foggyhlw/Motion-Sensor/README.md

# Motion-Sensor
## DIY人体存在传感器，使用LD2410雷达模块，辅助SR602热释电传感器避免误动，增加了BH1750光线传感器
## 视频教程：
### B站：https://www.bilibili.com/video/BV1Cs4y1Y7gm/
### 油管：https://www.youtube.com/watch?v=6fU20yu0re4&ab_channel=foggyhlw
