foggyhlw/Motion-Sensor/PCB打样相关文件/BOM清单.xlsx

No. | Quantity | Device | Designator | Footprint | 备注
1 | 3 | 1uf | C1,C6,C10 | C0805
2 | 2 | 100nF | C4,C5 | C0805
3 | 1 | 10uF | C9 | C0805
4 | 1 | FLASH | H1 | HDR-TH_4P-P2.54-V
5 | 1 | 直贴/两脚/3*6*2.5 | K1 | SW-SMD_L6.1-W3.6-LS8.0
6 | 1 | WS2812B-2020 | LED2 | LED-SMD_4P-L2.0-W2.0-TL_WS2812B-2020
7 | 6 | 10k | R8,R9,R10,R12,R13,R14 | R0805 | R12,R13，R14采用4.7k也可以
8 | 1 | DM-04-V | SW1 | SW-SMD_8P-L11.1-W6.2-P2.54-LS9.8
9 | 1 | ESP8266-12F | U2 | LGA22-2.0-24X16MM
10 | 1 | AMS1117-3.3_C917183 | U3 | SOT-223-3_L6.7-W3.7-P2.30-LS7.0-BR
11 | 1 | LD2410 | U10 | LD2410
12 | 1 | USB_TYPE-C_16 | U12 | USB-C-SMD_TYPE-C-USB-5
13 | 1 | BH1750FVI-TR | U13 | WSOF-6_L2.6-W1.6-P0.50-TL-EP
14 | 1 | SR602人体红外感应模块 | U14 | SR602人体红外感应模块
15 | 1 | 1k | R11 | R0805
