foggyhlw/Motion-Sensor/外壳/3d外壳_B.stl

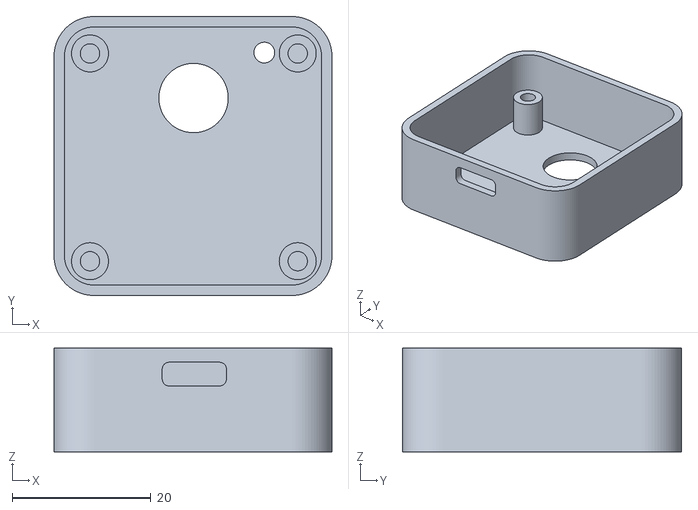
[picture p1: CAD file, 2023-02-09]
外壳/3d外壳_B.stl
40.1 x 40.2 x 15.0
