foggyhlw/Motion-Sensor/外壳/3d外壳_T.stl

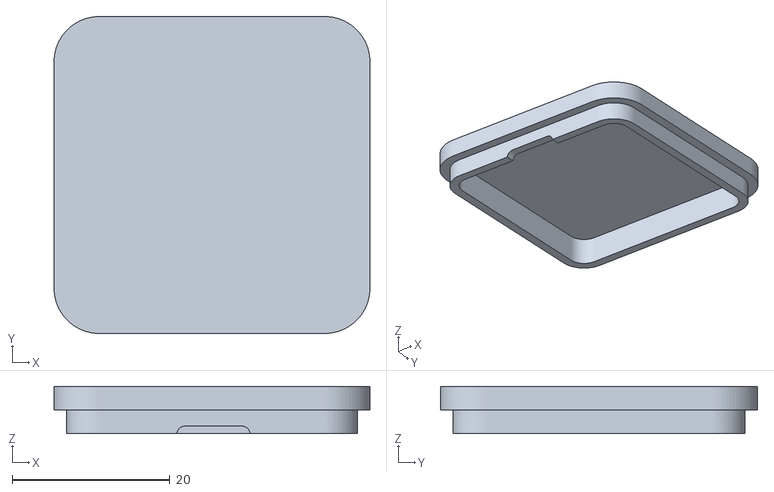
[picture p2: CAD file, 2023-02-09]
外壳/3d外壳_T.stl
40.1 x 40.2 x 6.00
