foggyhlw/Motion-Sensor/外壳/注塑铜滚花螺母/3DShell_T.stl

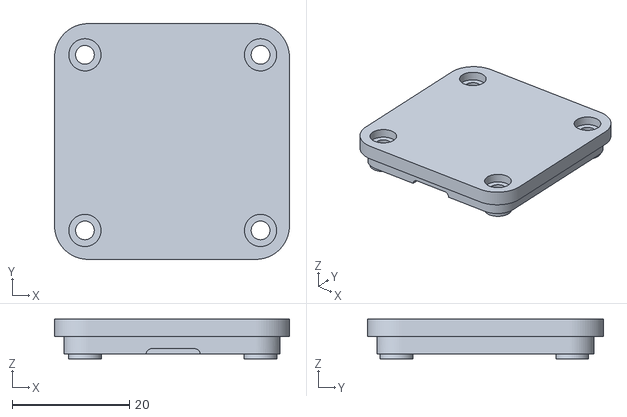
[picture p3: CAD file, 2023-12-17]
外壳/注塑铜滚花螺母/3DShell_T.stl
40.1 x 40.2 x 6.80
