foggyhlw/Motion-Sensor/(list of files, cad)

Other CAD files:
外壳/注塑铜滚花螺母/3DShell_B.stl
