foggyhlw/Motion-Sensor/PCB打样相关文件/电路原理图.pdf

### GND

+3.3V

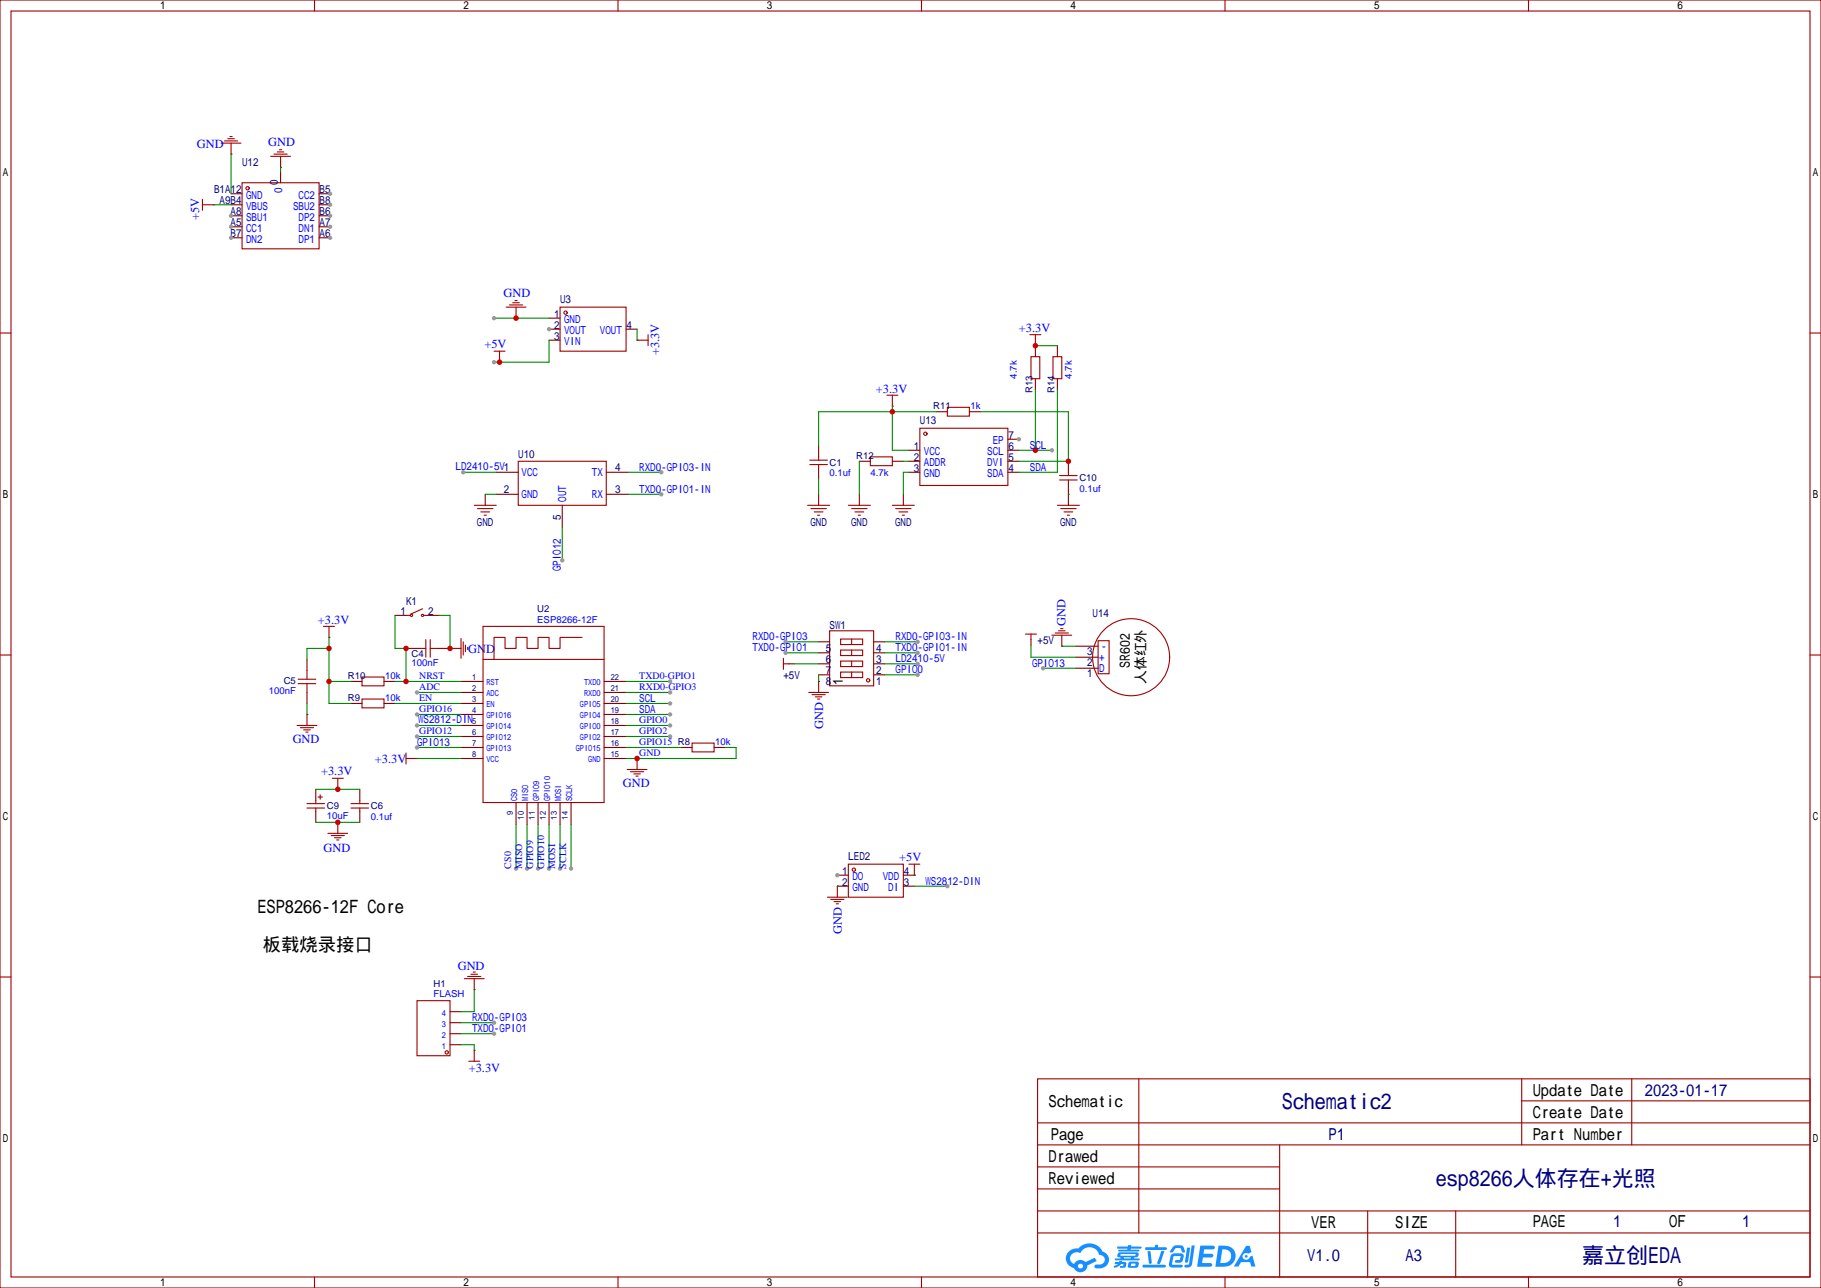
[picture p4: page 1]
