foggyhlw/Motion-Sensor/(threads)

Thread 3 (2023-06-11):

ESPHOME编译失败

UMP45-Team404, 2023-06-11:
日志如下：
INFO ESPHome 2023.5.5
INFO Reading configuration /config/esphome/ld2410.yaml...
Failed config

uart: [source /config/esphome/ld2410.yaml:41]
  -
    ID 'uart1' is reserved internally and cannot be used.
    id: uart1
    tx_pin: TX
    rx_pin: RX
    baud_rate: 256000
    parity: NONE
    stop_bits: 1
    debug:
      direction: BOTH
      dummy_receiver: False
      after:
        delimiter:
          - 248
          - 247
          - 246
          - 245

Thread 4 (2024-02-08):

如何在重启时保留配置

Yuke-hd, 2024-02-08:
getConfig 输出
```
重启前
[17:51:08][D][uart_debug:114]: <<< FD:FC:FB:FA:1A:00:61:01:00:00:00:00:00:00:00:00:00:00:00:00:00:00:00:00:00:00:00:00:00:00:00:00:04:03:02:01:F4:F3:F2:F1:0D:00:02:AA:02:9F:00:00:9F:00:64:8E:00:55:00:F8:F7:F6:F5

重启后
[17:52:06][D][uart_debug:114]: <<< FD:FC:FB:FA:1A:00:61:01:00:00:00:00:00:00:00:00:00:00:00:00:00:00:00:00:00:00:00:00:00:00:00:00:04:03:02:01:F4:F3:F2:F1:0D:00:02:AA:02:CF:00:00:CF:00:64:B3:00:55:00:F8:F7:F6:F5
```
