foggyhlw/Motion-Sensor/esphome固件&源码/ld2410.yaml

substitutions:
  room_name: room

esphome:
  name: ld2410
  includes:
    - ld2410_uart.h
  on_boot:
    priority: 600
    # ...
    then:
      - lambda: |-
          auto uart_component = static_cast<LD2410 *>(ld2410);
          uart_component->setNumbers(maxMovingDistanceRange, maxStillDistanceRange, noneDuration);

esp8266:
  board: d1_mini

logger:
  baud_rate: 0

api:

ota:

wifi:
  ssid: !secret wifi_ssid
  password: !secret wifi_password

  ap:
    ssid: "LD2410 Fallback Hotspot"

captive_portal:

i2c:
  sda: GPIO4
  scl: GPIO5
  scan: true
  id: bus_a

uart:
  id: uart_ld2410
  tx_pin: TX
  rx_pin: RX
  baud_rate: 256000 # Change this according to your setting
  parity: NONE
  stop_bits: 1
  debug:
    direction: BOTH
    dummy_receiver: false
    after:
      delimiter: [0xF8,0xF7,0xF6,0xF5]
      
custom_component:
  - lambda: |-
      return {new LD2410(id(uart_ld2410))};
    components:
      - id: ld2410
      
binary_sensor:
  - platform: custom
    lambda: |-
      auto uart_component = static_cast<LD2410 *>(ld2410);
      return {uart_component->hasTarget,uart_component->hasMovingTarget,uart_component->hasStillTarget,uart_component->lastCommandSuccess};
    binary_sensors:
      - name: "${room_name} Has Target"
      - name: "${room_name} Has Moving Target"
      - name: "${room_name} Has Still Target"
      - name: "${room_name} Last Command Success"
  - platform: gpio
    pin: GPIO13
    name: "${room_name} PIR Motion Sensor"
    device_class: motion
  
sensor:
  - platform: custom
    lambda: |-
      auto uart_component = static_cast<LD2410 *>(ld2410);
      return {uart_component->movingTargetDistance,uart_component->movingTargetEnergy,uart_component->stillTargetDistance,uart_component->stillTargetEnergy,uart_component->detectDistance};
    sensors:
      - name: "${room_name} Moving Distance"
        unit_of_measurement: "cm"
        accuracy_decimals: 0
      - name: "${room_name} Moving Energy"
        unit_of_measurement: "%"
        accuracy_decimals: 0
      - name: "${room_name} Still Distance"
        unit_of_measurement: "cm"
        accuracy_decimals: 0
      - name: "${room_name} Still Energy"
        unit_of_measurement: "%"
        accuracy_decimals: 0
      - name: "${room_name} Detect Distance"
        unit_of_measurement: "cm"
        accuracy_decimals: 0
  - platform: bh1750
    name: "${room_name} Illuminance"
    address: 0x23
    update_interval: 1s
number:        
  - platform: template
    name: "${room_name} Max Moving Distance Range"
    id: maxMovingDistanceRange
    min_value: 1
    max_value: 8
    step: 1
    update_interval: never
    optimistic: true
    set_action:
      - lambda: |-
          auto uart_component = static_cast<LD2410 *>(ld2410);
          uart_component->setMaxDistancesAndNoneDuration(x,id(maxStillDistanceRange).state,id(noneDuration).state);
  - platform: template
    name: "${room_name} Max Still Distance Range"
    id: maxStillDistanceRange
    min_value: 1
    max_value: 8
    step: 1
    update_interval: never
    optimistic: true
    set_action:
      - lambda: |-
          auto uart_component = static_cast<LD2410 *>(ld2410);
          uart_component->setMaxDistancesAndNoneDuration(id(maxMovingDistanceRange).state,x,id(noneDuration).state);
  - platform: template
    name: "${room_name} None Duration"
    id: noneDuration
    min_value: 0
    max_value: 32767
    step: 1
    mode: box
    update_interval: never
    optimistic: true
    set_action:
      - lambda: |-
          auto uart_component = static_cast<LD2410 *>(ld2410);
          uart_component->setMaxDistancesAndNoneDuration(id(maxMovingDistanceRange).state,id(maxStillDistanceRange).state,x);
      

button:
  - platform: template
    name: "${room_name} Reboot LD2410"
    on_press:
      lambda: 'static_cast<LD2410 *>(ld2410)->reboot();'
  - platform: template
    name: "${room_name} Turn on config mode"
    on_press:
      - lambda: 'static_cast<LD2410 *>(ld2410)->setConfigMode(true);'
  - platform: template
    name: "${room_name} Turn off config mode"
    on_press:
      - lambda: 'static_cast<LD2410 *>(ld2410)->setConfigMode(false);'
  - platform: template
    name: "${room_name} Get config"
    on_press:
      - lambda: 'static_cast<LD2410 *>(ld2410)->queryParameters();'
  - platform: template
    name: "${room_name} Set baud rate to 256000"
    on_press:
      - lambda: 'static_cast<LD2410 *>(ld2410)->setBaudrate(7);'
  - platform: template
    name: "${room_name} Set baud rate to 115200"
    on_press:
      - lambda: 'static_cast<LD2410 *>(ld2410)->setBaudrate(5);'
  - platform: template
    name: "${room_name} Set baud rate to 9600"
    on_press:
      - lambda: 'static_cast<LD2410 *>(ld2410)->setBaudrate(1);'

light:
  - platform: neopixelbus
    type: GRB
    variant: WS2812
    pin: GPIO14
    num_leds: 1
    name: "${room_name} NeoPixel Light"
