foggyhlw/Motion-Sensor/(commit log)

2023-02-13 Add new 3D shell
    [3DShell_B.stl, 3DShell_T.stl]
2023-02-18 更新bom清单
    [BOM清单.xlsx]
2023-12-17 Update ld2410.yaml
    修正了uart1的id问题
